antholuo/rnm-75E/3d outputs/4b918af5-770b-4cc3-8189-42923c4cc60b.PNG

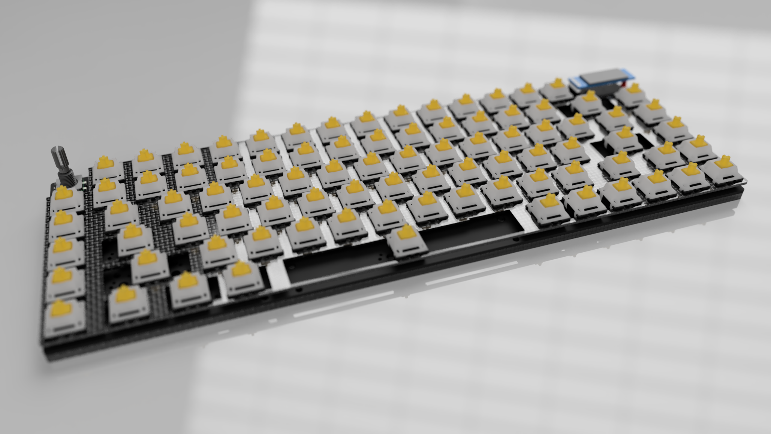
3d outputs/4b918af5-770b-4cc3-8189-42923c4cc60b.PNG
