antholuo/rnm-75E/PLOTS/keyboard-layout (1).png

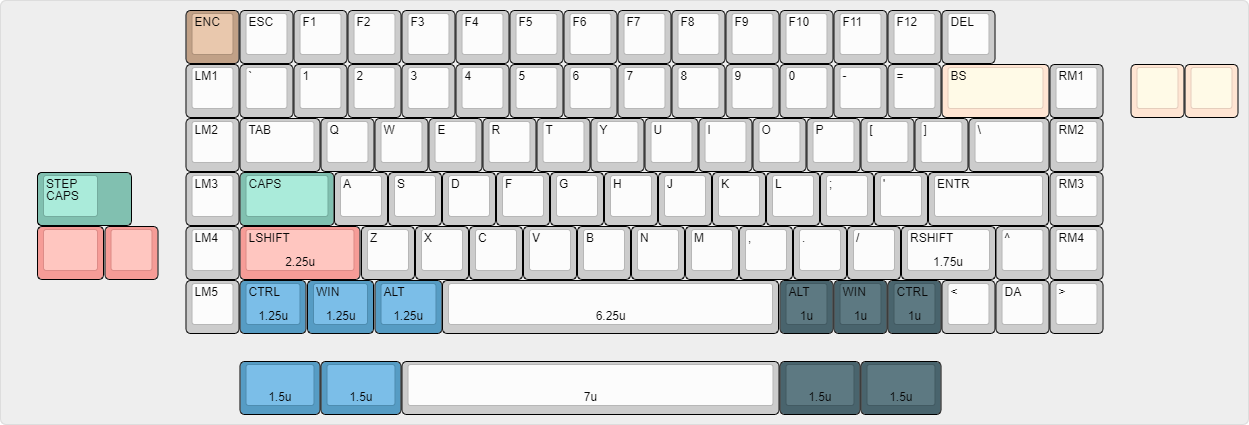
PLOTS/keyboard-layout (1).png
