antholuo/rnm-75E/3d outputs/plate_hopefully.dxf

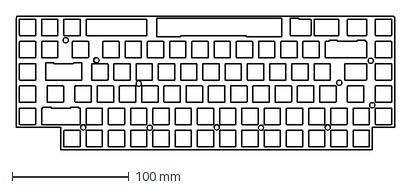
[picture p3: CAD file, 2021-05-18]
3d outputs/plate_hopefully.dxf
323.8 x 114.3 mm
