antholuo/rnm-75E/3d outputs/asm_mx_asm_PCB.stp

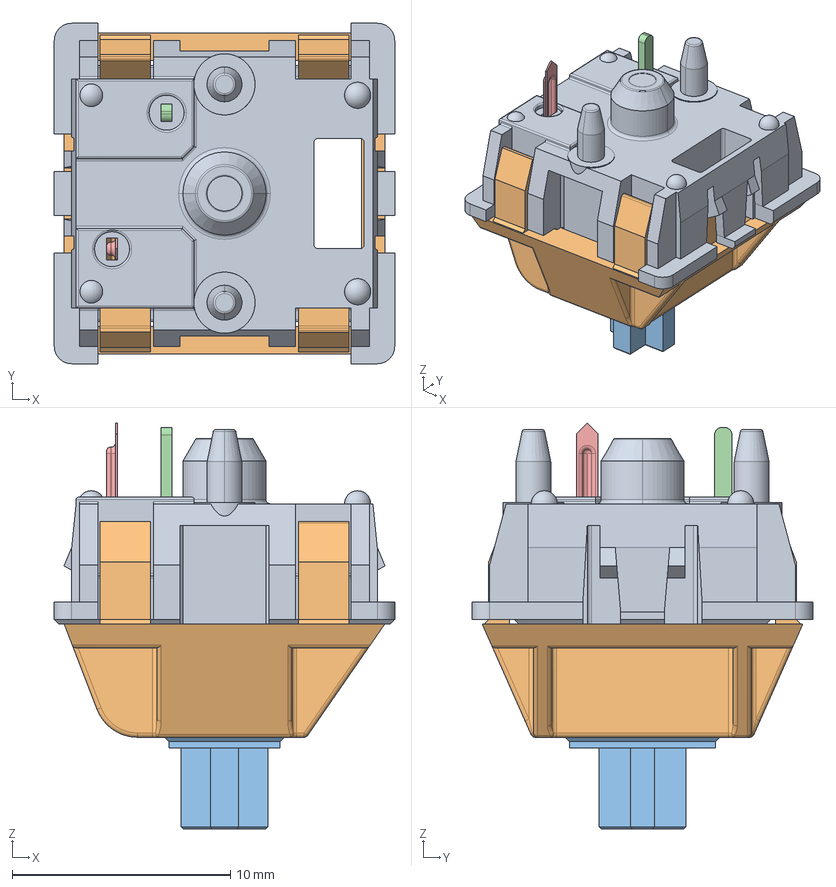
[picture p4: CAD file, 2021-05-16]
3d outputs/asm_mx_asm_PCB.stp
15.6 x 15.6 x 18.6 mm
MX_DOWN
MX_UP
UP_MX
MX_PIN
MX_SPRING
MX_CLICK
