antholuo/rnm-75E/PLATE/midplate2.dxf

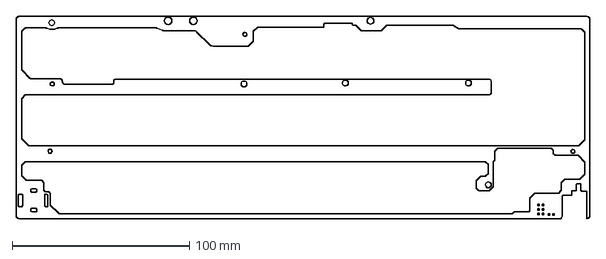
[picture p5: CAD file, 2021-05-29]
PLATE/midplate2.dxf
323.9 x 114.3 mm
