antholuo/rnm-75E/3d outputs/kbplate_with_holes v12.dxf

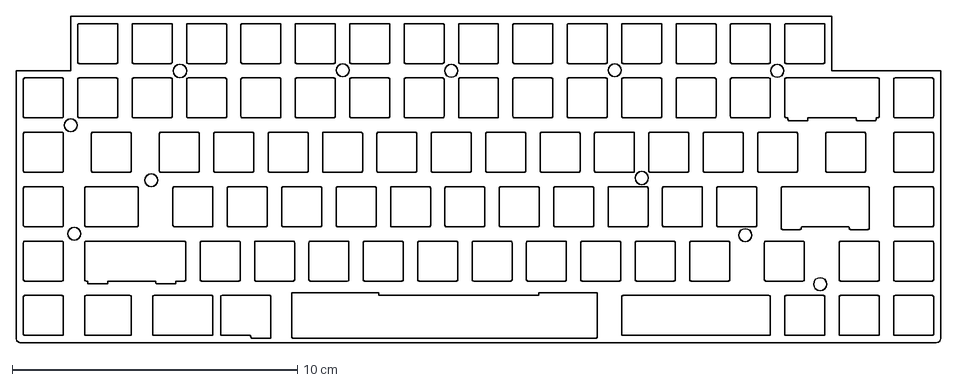
[picture p6: CAD file, 2021-05-18]
3d outputs/kbplate_with_holes v12.dxf
32.4 x 11.4 cm
