antholuo/rnm-75E/3d outputs/platev12wepray2.dxf

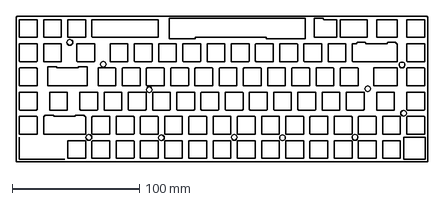
[picture p7: CAD file, 2021-05-18]
3d outputs/platev12wepray2.dxf
323.9 x 114.3 mm
