antholuo/rnm-75E/PLATE/midplate4.dxf

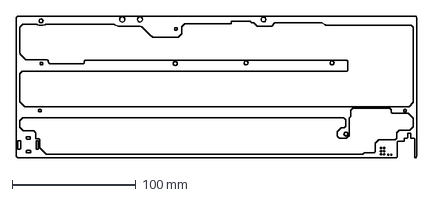
[picture p8: CAD file, 2021-05-29]
PLATE/midplate4.dxf
323.8 x 114.3 mm
