antholuo/rnm-75E/3d outputs/platev12wepray.dxf

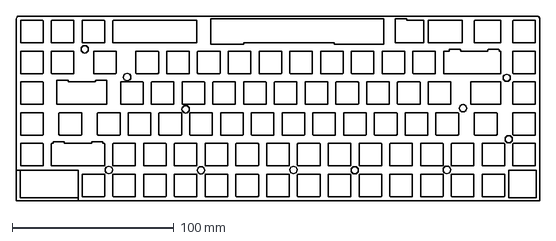
[picture p9: CAD file, 2021-05-18]
3d outputs/platev12wepray.dxf
323.9 x 114.3 mm
