antholuo/rnm-75E/PLATE/plate.step

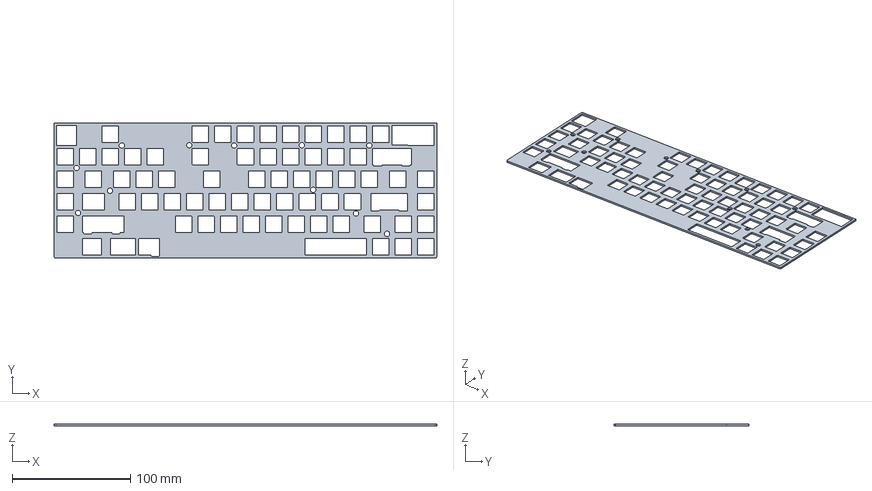
[picture p10: CAD file, 2021-05-22]
PLATE/plate.step
323.8 x 114.3 x 1.60 mm
