antholuo/rnm-75E/3d outputs/kbplate_with_holes v11.step

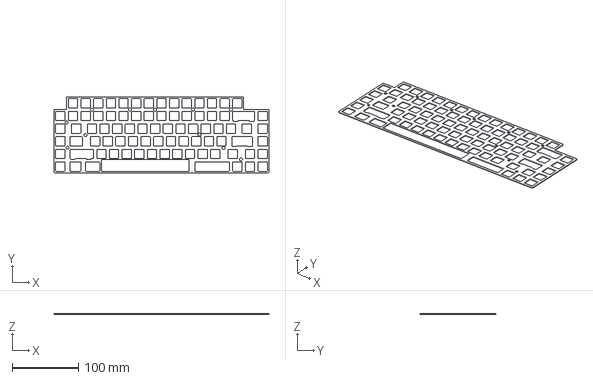
[picture p11: CAD file, 2021-05-18]
3d outputs/kbplate_with_holes v11.step
323.9 x 114.3 x 1.50 mm
