antholuo/rnm-75E/PLATE/midlayer v9.dxf

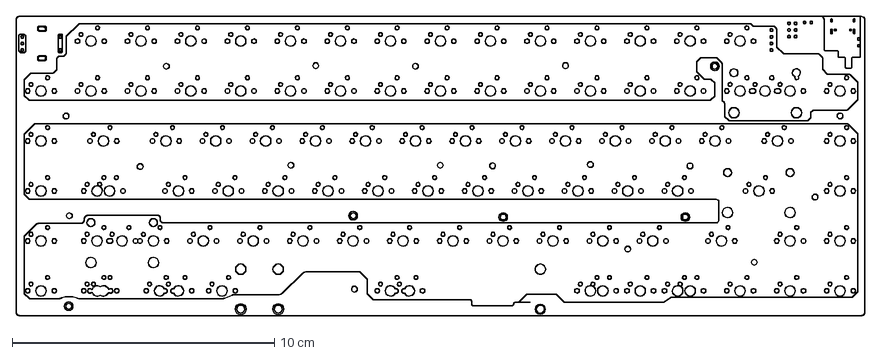
[picture p12: CAD file, 2021-05-22]
PLATE/midlayer v9.dxf
32.4 x 11.4 cm
