antholuo/rnm-75E/PLATE/midplate1.dxf

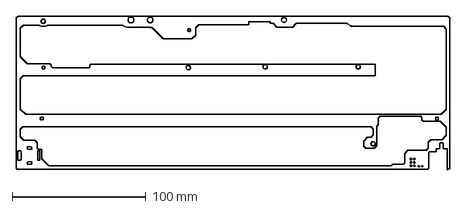
[picture p13: CAD file, 2021-05-22]
PLATE/midplate1.dxf
323.9 x 114.3 mm
