antholuo/rnm-75E/PLATE/midlayer v15.step

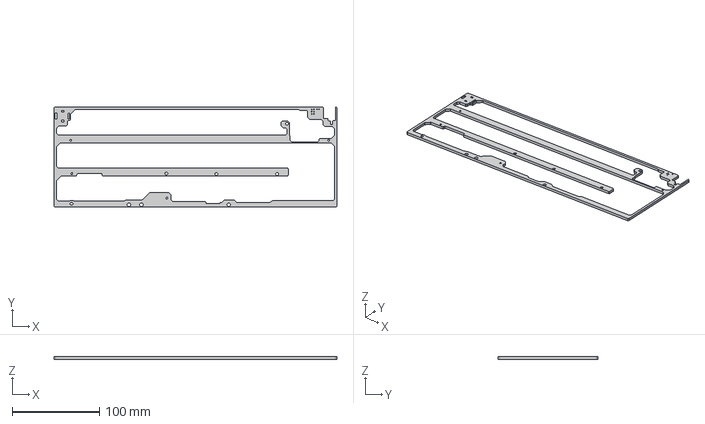
[picture p14: CAD file, 2021-05-22]
PLATE/midlayer v15.step
323.8 x 114.3 x 3.00 mm
