antholuo/rnm-75E/3d outputs/EC11_Rotary_Encoder_Switched.step

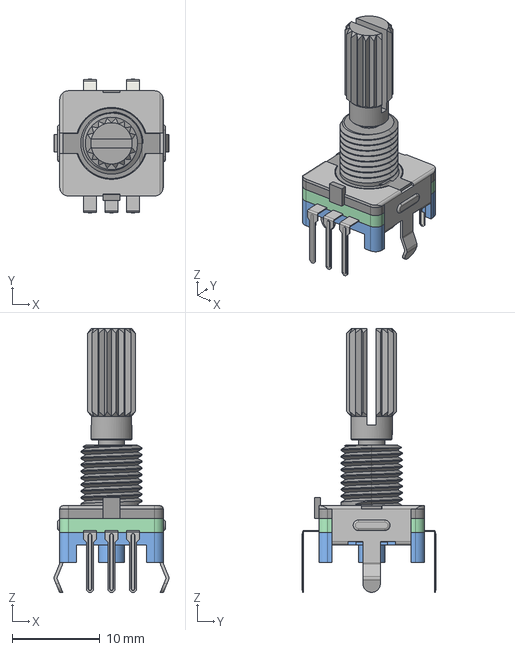
[picture p15: CAD file, 2021-05-17]
3d outputs/EC11_Rotary_Encoder_Switched.step
13.1 x 15.3 x 30.1 mm
