antholuo/rnm-75E/3d outputs/kbplate.dxf

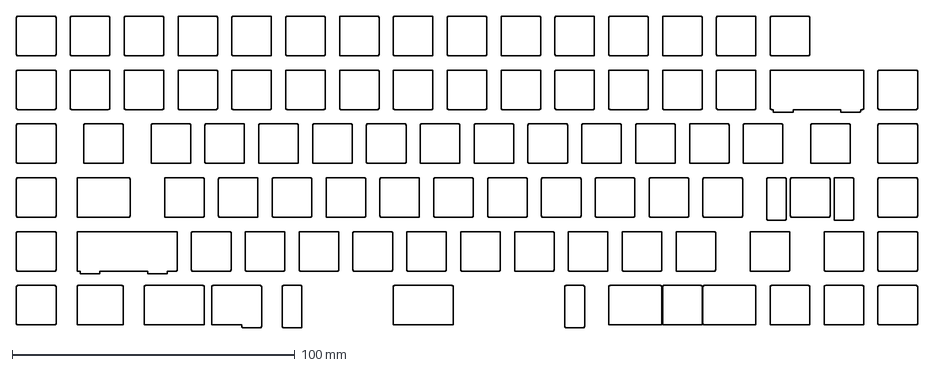
[picture p16: CAD file, 2021-05-16]
3d outputs/kbplate.dxf
318.8 x 110.2 mm
