antholuo/rnm-75E/3d outputs/ai03 plate.dxf

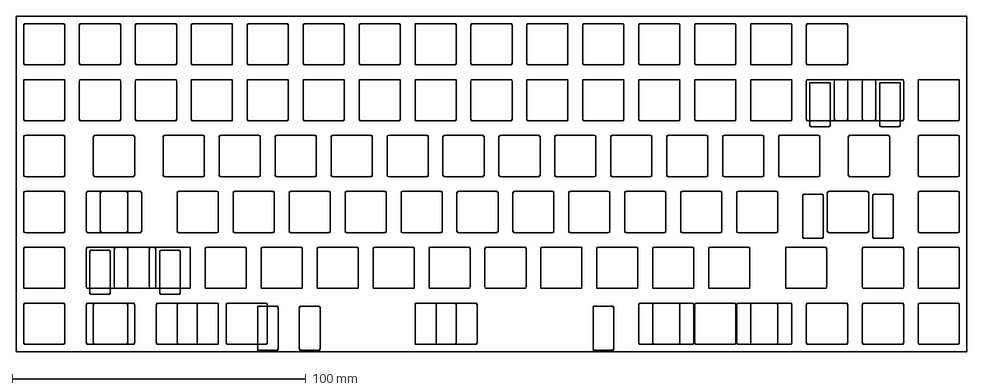
[picture p17: CAD file, 2021-05-16]
3d outputs/ai03 plate.dxf
323.9 x 114.3 mm
