antholuo/rnm-75E/3d outputs/OLED 32x 128.SLDPRT

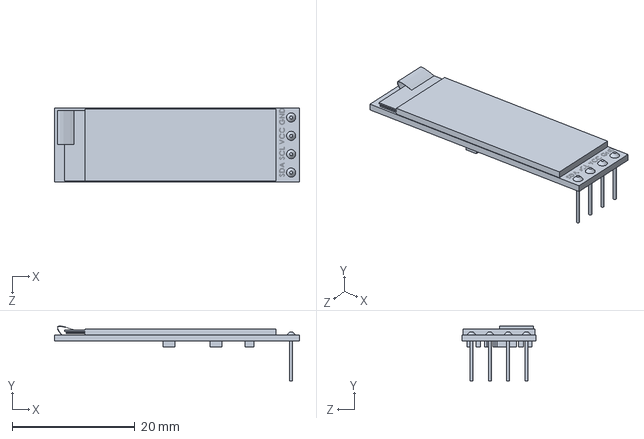
[picture p18: CAD file, 2021-05-16]
3d outputs/OLED 32x 128.SLDPRT
40.0 x 8.96 x 12.0 mm
