antholuo/rnm-75E/3d outputs/Monochrome 0.91’’ 128x32 I2C OLED Display DFR0647 (DFROBOT).STEP

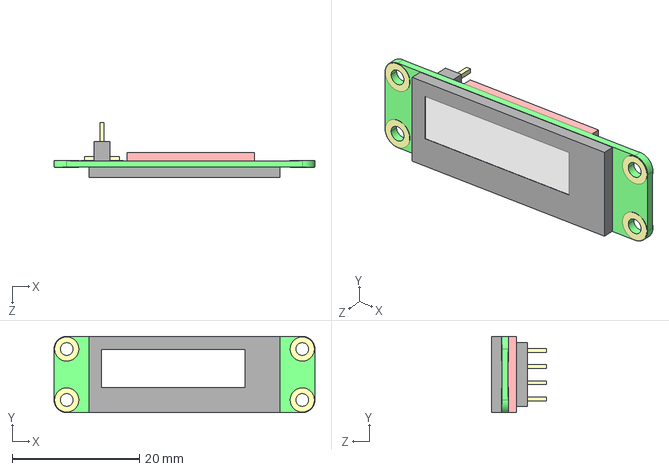
[picture p19: CAD file, 2021-05-16]
3d outputs/Monochrome 0.91’’ 128x32 I2C OLED Display DFR0647 (DFROBOT).STEP
41.0 x 12.0 x 8.60 mm
