antholuo/rnm-75E/3d outputs/plate-20210514-165338.dxf

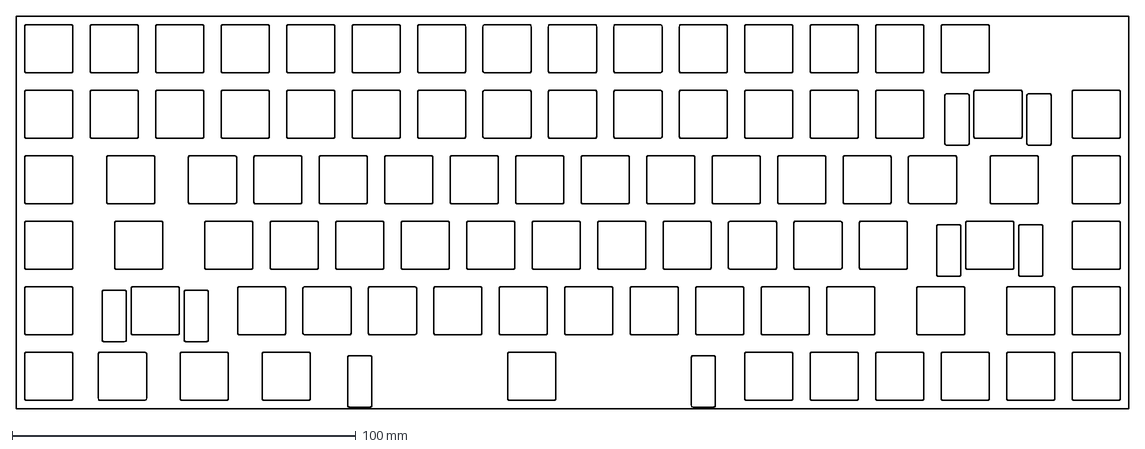
[picture p20: CAD file, 2021-05-15]
3d outputs/plate-20210514-165338.dxf
323.9 x 114.3 mm
