antholuo/rnm-75E/3d outputs/plate_no_oled.dxf

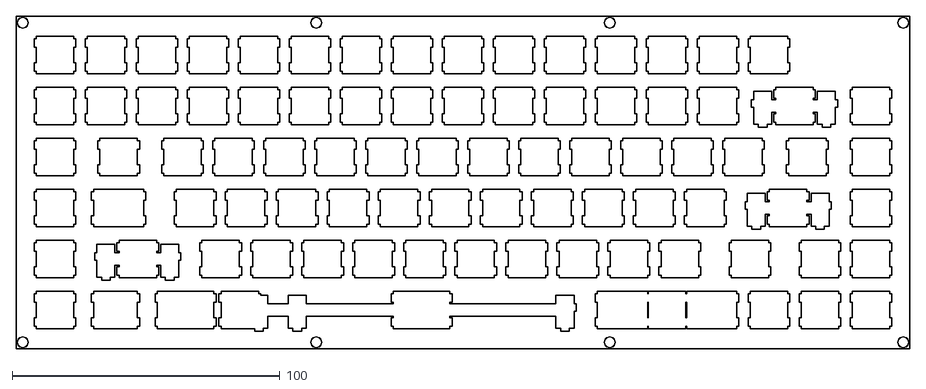
[picture p21: CAD file, 2021-05-15]
3d outputs/plate_no_oled.dxf
333.8 x 124.3
