antholuo/rnm-75E/3d outputs/SSD1306_OLED-0.91-128x32.step

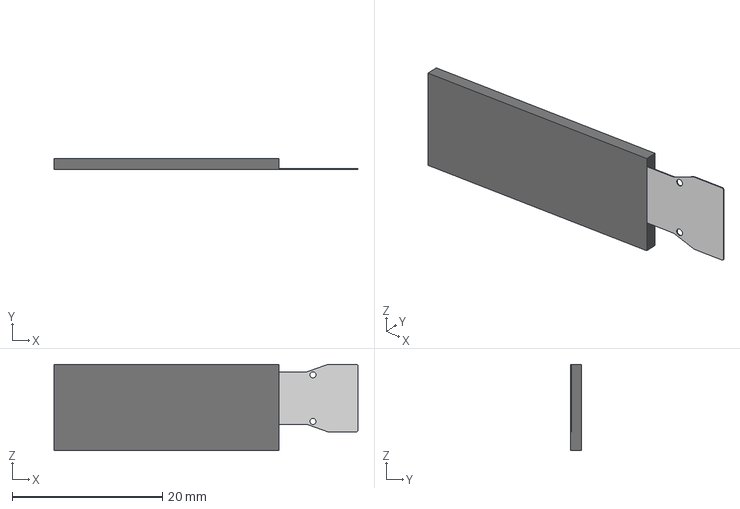
[picture p22: CAD file, 2021-05-12]
3d outputs/SSD1306_OLED-0.91-128x32.step
40.5 x 1.45 x 11.5 mm
