antholuo/rnm-75E/(list of files, cad)

Other CAD files:
3d outputs/kbplate_with_holes v17.dwg
3d outputs/plate1.stl
3d outputs/kbplate_with_holes v11.dxf
