antholuo/rnm-75E/PLOTS/rnm-75E.pdf

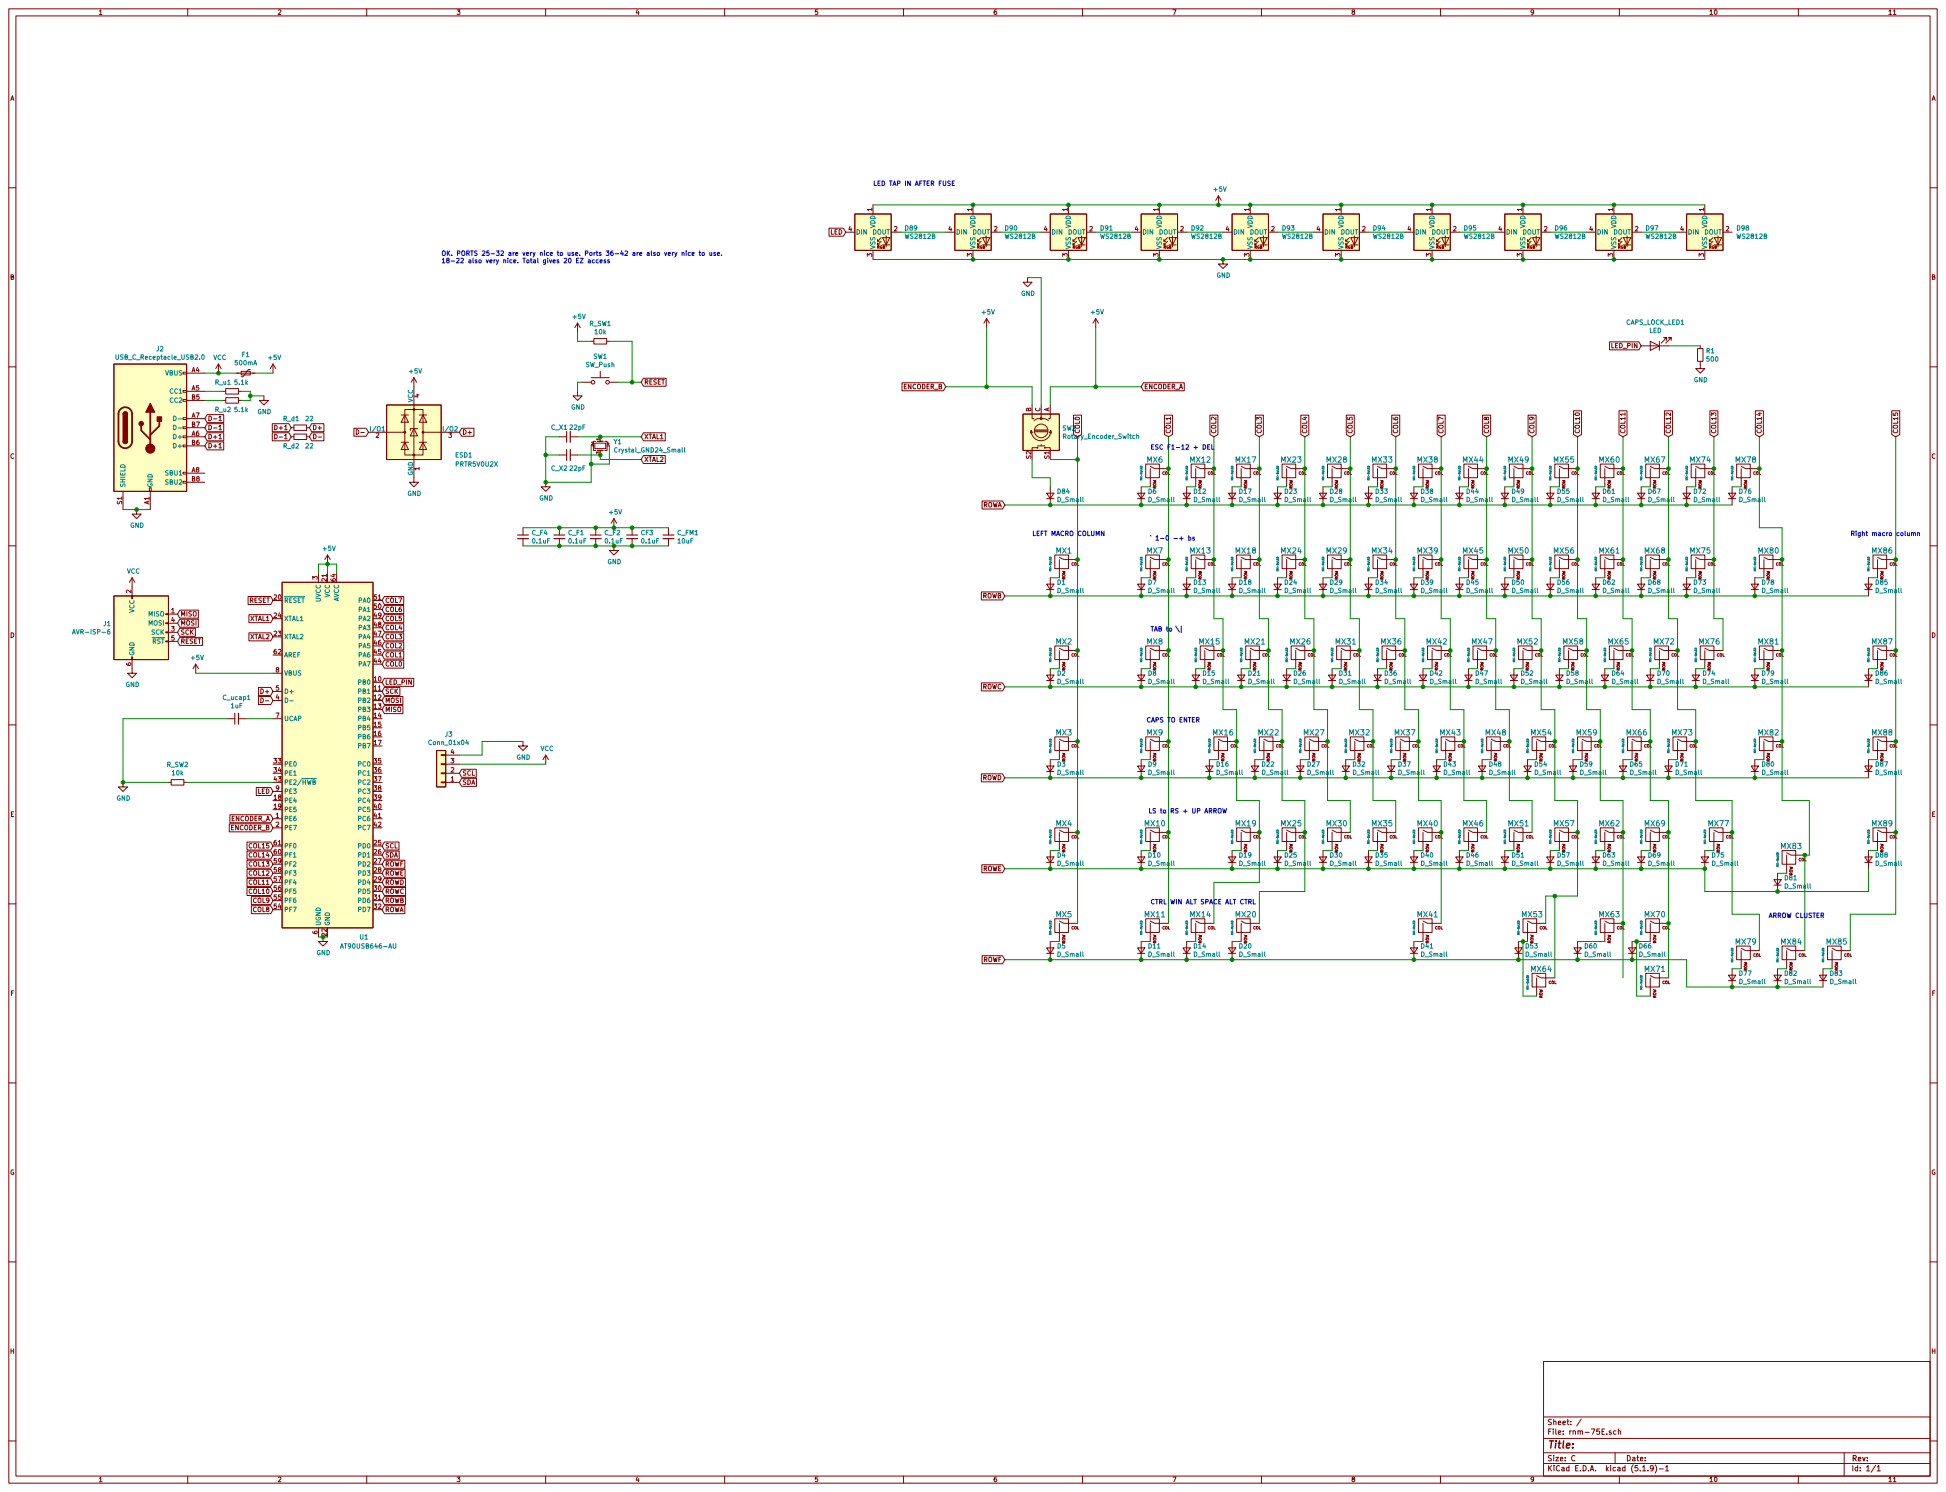
[picture p23: page 1]

LED TAP IN AFTER FUSE

TAB to \| ` 1-0 -+ bs ESC F1-12 + DEL OK. PORTS 25-32 are very nice to use. Ports 36-42 are also very nice to use.
18-22 also very nice. Total gives 20 EZ access
SW1 SW_Push GND

A S2S1 SW2 Rotary_Encoder_Switch D85 D_Small COL ROW MX86 MX-NoLED D75 D_Small COL ROW MX77 MX-NoLED D69 D_Small COL ROW MX69 MX-NoLED D63 D_Small

COL ROW MX74 MX-NoLED

D76 D_Small COL ROW MX78 MX-NoLED

COL ROW MX24 MX-NoLED D18 D_Small COL ROW MX18 MX-NoLED D13 D_Small COL ROW MX13 MX-NoLED D7D_Small COL ROW MX7 MX-NoLED

6 PF1 60 PF0 61 AREF 62 AVCC 64 UCAP 7 VBUS 8 PE3 9 U1 AT90USB646-AU D60 D_Small COL ROW MX63 MX-NoLED COL ROW MX70 MX-NoLED D41 D_Small D3D_Small D20 D_Small COL ROW MX20 MX-NoLED D14 D_Small COL ROW MX14 MX-NoLED D11 D_Small COL ROW MX11 MX-NoLED

2 SCK 3 MOSI 4 RST 5 GND

COL ROW MX65 MX-NoLED

COL ROW MX87 MX-NoLED

COL ROW MX16 MX-NoLED D9D_Small COL ROW MX9 MX-NoLED

LS to RS + UP ARROW
COL ROW MX30 MX-NoLED D25 D_Small COL ROW MX25 MX-NoLED D19 D_Small COL ROW MX19 MX-NoLED D10 D_Small COL ROW MX10 MX-NoLED

SCL ROWA ROWF ROWD

COL ROW MX41 MX-NoLED

COL ROW MX53 MX-NoLED

COL ROW MX79 MX-NoLED

D83 D_Small COL ROW MX85 MX-NoLED D77 D_Small

COL ROW MX64 MX-NoLED

Id: 1/1 Title: File: rnm-75E.sch Sheet: /
