antholuo/rnm-75E/PLOTS/rnm-75e-oneone.pdf

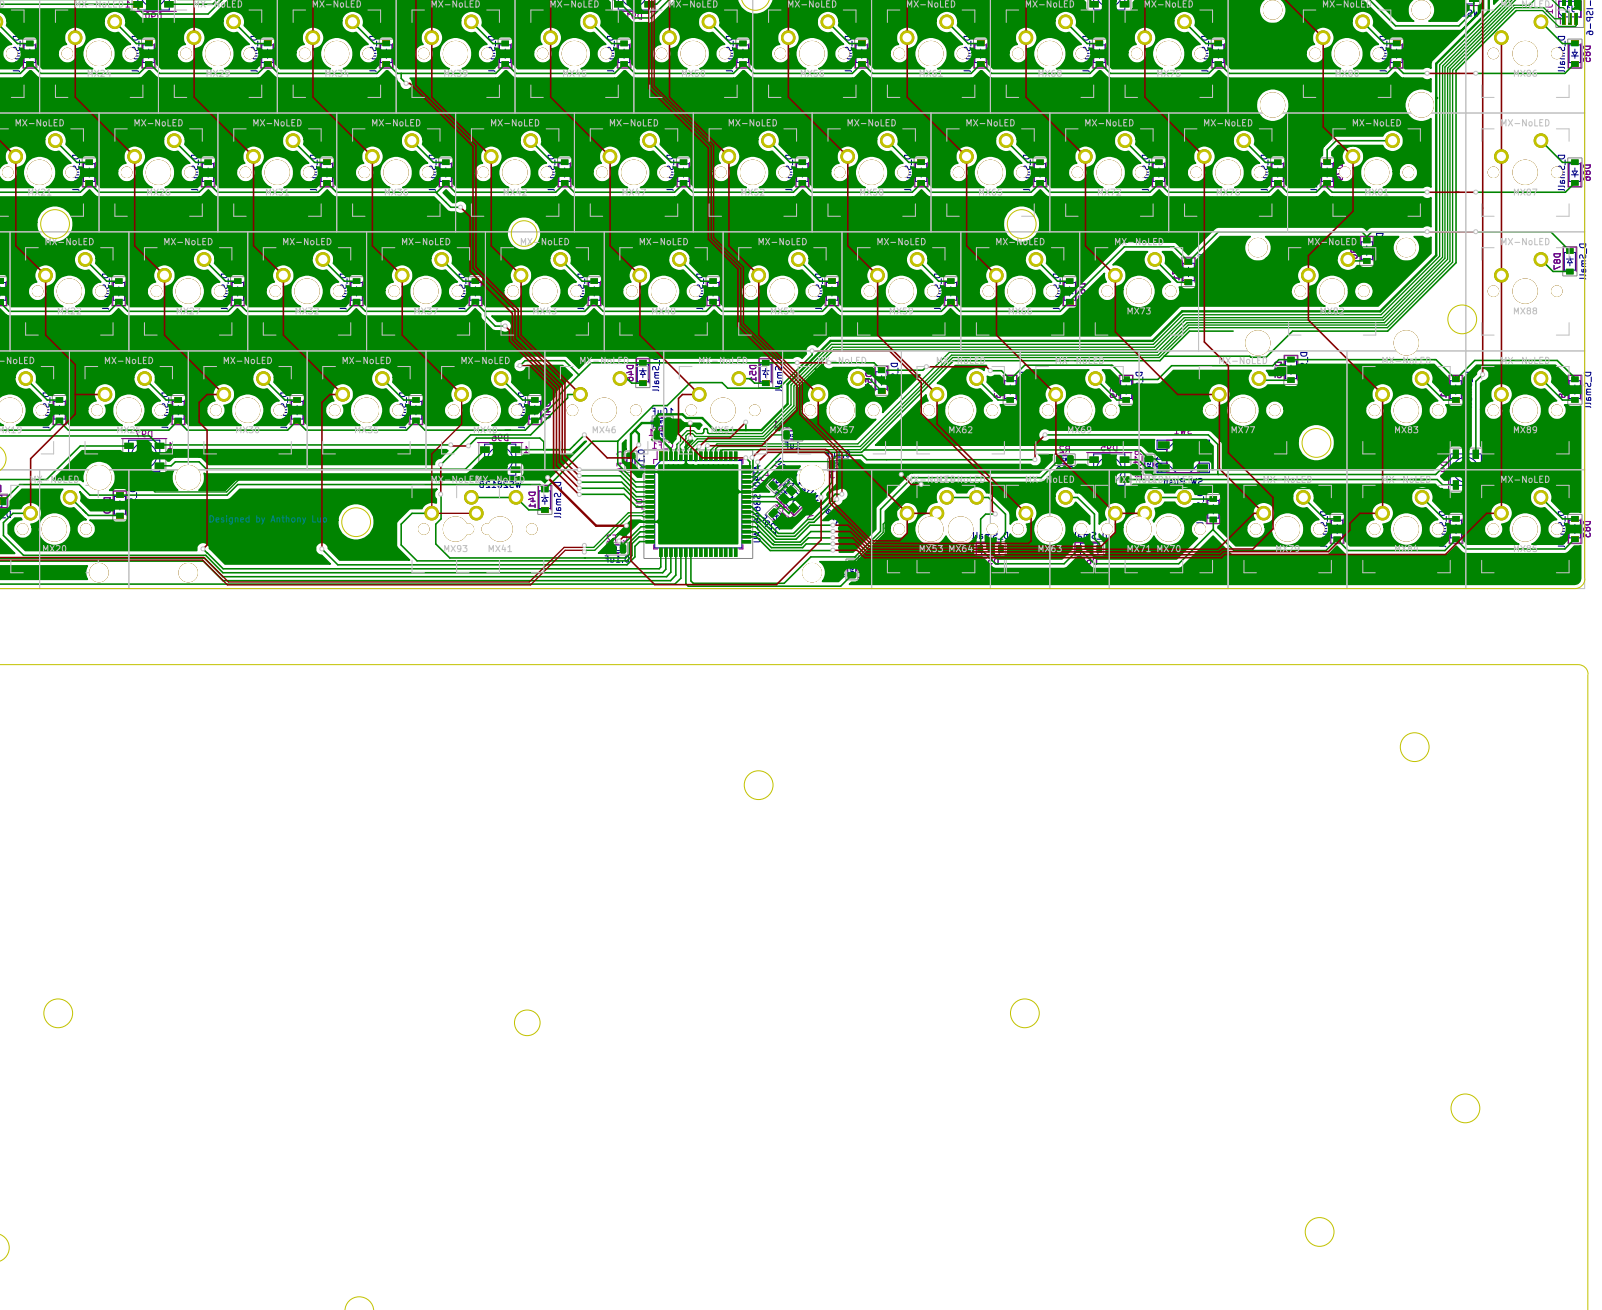
[picture p24: page 1]
