antholuo/rnm-75E/PLOTS/render.pdf

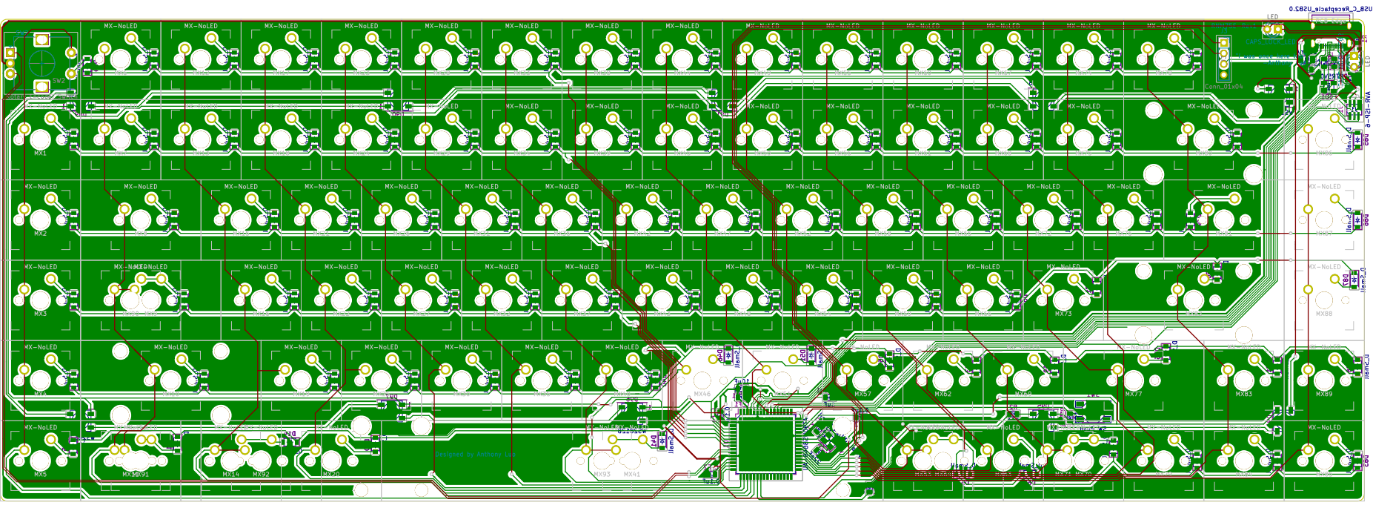
[picture p25: page 1]
