antholuo/rnm-75E/(list of files, drawings)

Other design files:
3d outputs/rnm-75E.dsn
