antholuo/rnm-75E/rnm-75E.kicad_pcb

## KiCad design rnm-75E.kicad_pcb (2021-05-18)

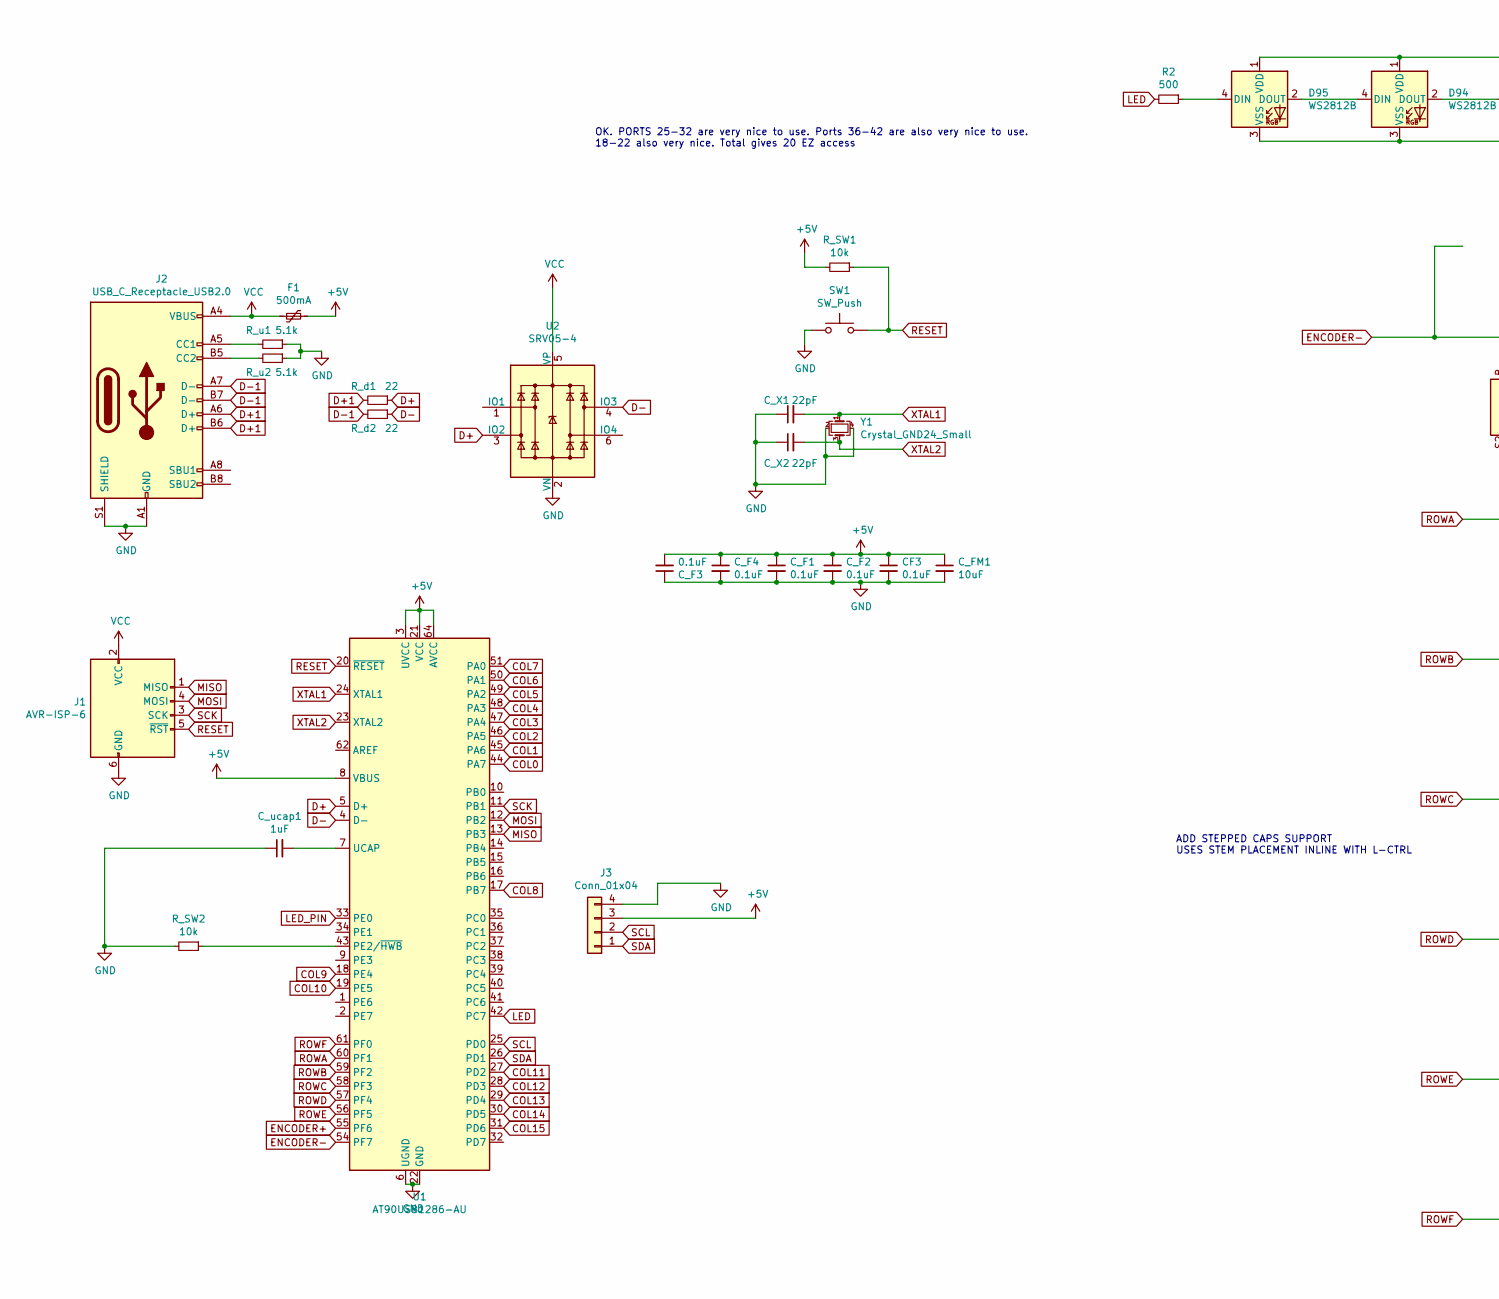
[picture p26: schematic rnm-75E.sch, part in row 1, column 1]

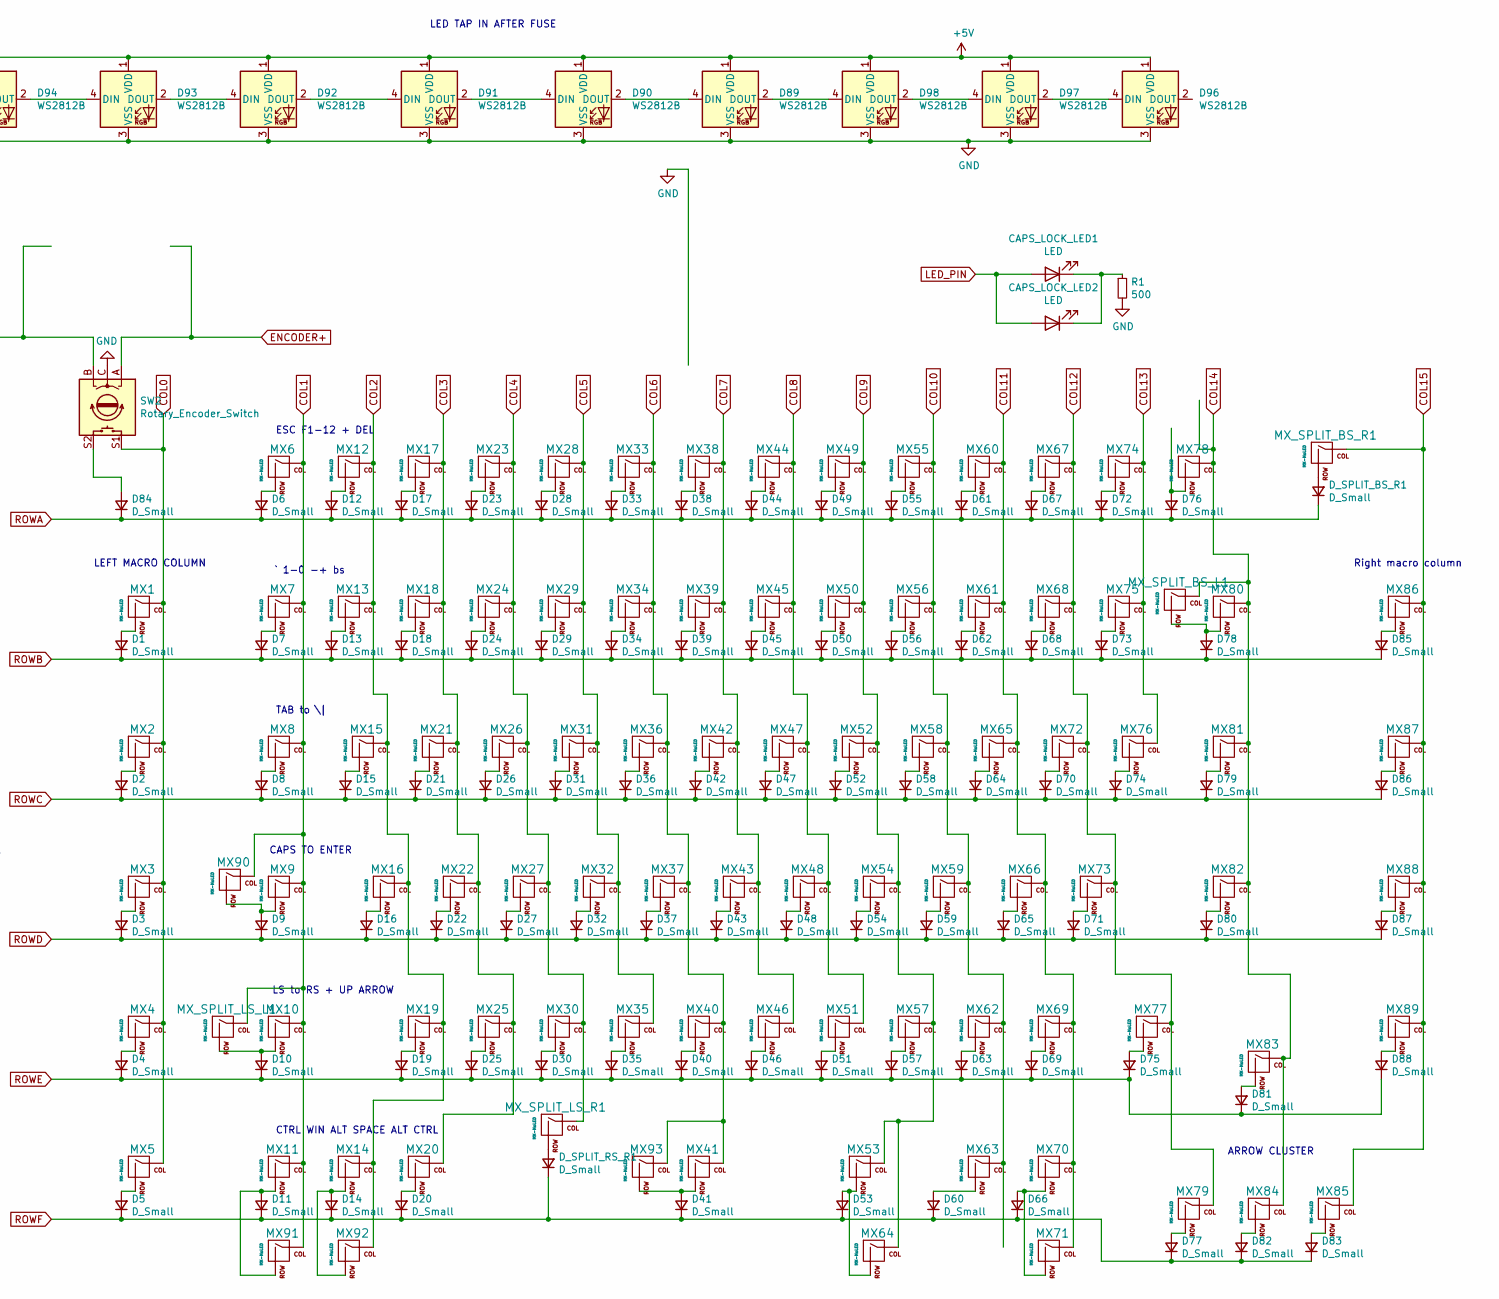
[picture p27: schematic rnm-75E.sch, part in row 1, column 2]

Parts:
CAPS_LOCK_LED1, CAPS_LOCK_LED2: LED; LED_D3.0mm
CF3: 0.1uF; C_0805_2012Metric
C_F1, C_F2, C_F3, C_F4: 0.1uF; C_0805_2012Metric
C_FM1: 10uF; C_0805_2012Metric
C_X1, C_X2: 22pF; C_0805_2012Metric
C_ucap1: 1uF; C_0805_2012Metric
D1, D2, D3, D4, D5, D6, D7, D8, D9, D10, D11, D12, D13, D14, D15, D16, D17, D18, D19, D20, D21, D22, D23, D24, D25, D26, D27, D28, D29, D30, D31, D32, D33, D34, D35, D36, D37, D38, D39, D40, D41, D42, D43, D44, D45, D46, D47, D48, D49, D50, D51, D52, D53, D54, D55, D56, D57, D58, D59, D60, D61, D62, D63, D64, D65, D66, D67, D68, D69, D70, D71, D72, D73, D74, D75, D76, D77, D78, D79, D80, D81, D82, D83, D84, D85, D86, D87, D88: D_Small; D_SOD-123
D89, D90, D91, D92, D93, D94, D95, D96, D97, D98: WS2812B; LED_WS2812B_PLCC4_5.0x5.0mm_P3.2mm
D_SPLIT_BS_R1: D_Small; D_SOD-123
D_SPLIT_RS_R1: D_Small; D_SOD-123
F1: 500mA; Fuse_1206_3216Metric
J1: AVR-ISP-6; Reset_Pretty-Mask
J2: USB_C_Receptacle_USB2.0; USB_C_Receptacle_HRO_TYPE-C-31-M-12
J3: Conn_01x04; PinSocket_1x04_P2.54mm_Vertical
MX1, MX2, MX3, MX4, MX5, MX6, MX7, MX12, MX13, MX15, MX16, MX17, MX18, MX19, MX21, MX22, MX23, MX24, MX25, MX26, MX27, MX28, MX29, MX30, MX31, MX32, MX33, MX34, MX35, MX36, MX37, MX38, MX39, MX40, MX42, MX43, MX44, MX45, MX46, MX47, MX48, MX49, MX50, MX51, MX52, MX53, MX54, MX55, MX56, MX57, MX58, MX59, MX60, MX61, MX62, MX63, MX65, MX66, MX67, MX68, MX69, MX70, MX72, MX73, MX74, MX75, MX76, MX78, MX79, MX83, MX84, MX85, MX86, MX87, MX88, MX89: MX-NoLED; MXOnly-1U-NoLED
MX8, MX64, MX71, MX81, MX91, MX92: MX-NoLED; MXOnly-1.5U-NoLED
MX9, MX77: MX-NoLED; MXOnly-1.75U-NoLED
MX10, MX82: MX-NoLED; MXOnly-2.25U-NoLED
MX11, MX14, MX20, MX90: MX-NoLED; MXOnly-1.25U-NoLED
MX41: MX-NoLED; MXOnly-6.25U-ReversedStabilizers-NoLED
MX80: MX-NoLED; MXOnly-2U-NoLED
MX93: MX-NoLED; MXOnly-7U-ReversedStabilizers-NoLED
MX_SPLIT_BS_L1: MX-NoLED; MXOnly-1U-NoLED
MX_SPLIT_BS_R1: MX-NoLED; MXOnly-1U-NoLED
MX_SPLIT_LS_L1: MX-NoLED; MXOnly-1.25U-NoLED
MX_SPLIT_LS_R1: MX-NoLED; MXOnly-1U-NoLED
R1, R2: 500; R_0805_2012Metric
R_SW1, R_SW2: 10k; R_0805_2012Metric
R_d1, R_d2: 22; R_0805_2012Metric
R_u1, R_u2: 5.1k; R_0805_2012Metric
SW1: SW_Push; SKQG-1155865
SW2: Rotary_Encoder_Switch; RotaryEncoder_Alps_EC11E-Switch_Vertical_H20mm
U1: AT90USB1286-AU; TQFP-64_14x14mm_P0.8mm
U2: SRV05-4; SOT-23-6
Y1: Crystal_GND24_Small; Crystal_SMD_3225-4Pin_3.2x2.5mm

Connections:
+5V: CF3.1, C_F1.1, C_F2.1, C_F3.2, C_F4.1, C_FM1.1, D89.1 (VDD), D90.1 (VDD), D91.1 (VDD), D92.1 (VDD), D93.1 (VDD), D94.1 (VDD), D95.1 (VDD), D96.1 (VDD), D97.1 (VDD), D98.1 (VDD), F1.1, J3.3, R_SW1.2, U1.3 (UVCC), U1.8 (VBUS), U1.21 (VCC), U1.52 (VCC), U1.64 (AVCC)
COL0: MX1.1 (COL), MX2.1 (COL), MX3.1 (COL), MX4.1 (COL), MX5.1 (COL), SW2.S1, U1.44 (PA7)
COL1: MX6.1 (COL), MX7.1 (COL), MX8.1 (COL), MX9.1 (COL), MX10.1 (COL), MX11.1 (COL), MX90.1 (COL), MX91.1 (COL), MX_SPLIT_LS_L1.1 (COL), U1.45 (PA6)
COL2: MX12.1 (COL), MX13.1 (COL), MX14.1 (COL), MX15.1 (COL), MX16.1 (COL), MX19.1 (COL), MX92.1 (COL), U1.46 (PA5)
COL3: MX17.1 (COL), MX18.1 (COL), MX20.1 (COL), MX21.1 (COL), MX22.1 (COL), MX25.1 (COL), U1.47 (PA4)
COL4: MX23.1 (COL), MX24.1 (COL), MX26.1 (COL), MX27.1 (COL), MX30.1 (COL), MX_SPLIT_LS_R1.1 (COL), U1.48 (PA3)
COL5: MX28.1 (COL), MX29.1 (COL), MX31.1 (COL), MX32.1 (COL), MX35.1 (COL), U1.49 (PA2)
COL6: MX33.1 (COL), MX34.1 (COL), MX36.1 (COL), MX37.1 (COL), MX40.1 (COL), MX41.1 (COL), MX93.1 (COL), U1.50 (PA1)
COL7: MX38.1 (COL), MX39.1 (COL), MX42.1 (COL), MX43.1 (COL), MX46.1 (COL), U1.51 (PA0)
COL8: MX44.1 (COL), MX45.1 (COL), MX47.1 (COL), MX48.1 (COL), MX51.1 (COL), U1.17 (PB7)
COL9: MX49.1 (COL), MX50.1 (COL), MX52.1 (COL), MX53.1 (COL), MX54.1 (COL), MX57.1 (COL), MX64.1 (COL), U1.18 (PE4)
COL10: MX55.1 (COL), MX56.1 (COL), MX58.1 (COL), MX59.1 (COL), MX62.1 (COL), MX63.1 (COL), U1.19 (PE5)
COL11: MX60.1 (COL), MX61.1 (COL), MX65.1 (COL), MX66.1 (COL), MX69.1 (COL), MX70.1 (COL), MX71.1 (COL), U1.27 (PD2)
COL12: MX67.1 (COL), MX68.1 (COL), MX72.1 (COL), MX73.1 (COL), MX77.1 (COL), MX79.1 (COL), U1.28 (PD3)
COL13: MX74.1 (COL), MX75.1 (COL), MX76.1 (COL), U1.29 (PD4)
COL14: MX78.1 (COL), MX80.1 (COL), MX81.1 (COL), MX82.1 (COL), MX83.1 (COL), MX84.1 (COL), MX_SPLIT_BS_L1.1 (COL), U1.30 (PD5)
COL15: MX85.1 (COL), MX86.1 (COL), MX87.1 (COL), MX88.1 (COL), MX89.1 (COL), MX_SPLIT_BS_R1.1 (COL), U1.31 (PD6)
D+: R_d1.1, U1.5 (D+), U2.3 (IO2)
D+1: J2.A6 (D+), J2.B6 (D+), R_d1.2
D-: R_d2.1, U1.4 (D-), U2.4 (IO3)
D-1: J2.A7 (D-), J2.B7 (D-), R_d2.2
ENCODER+: SW2.A, U1.55 (PF6)
ENCODER-: SW2.B, U1.54 (PF7)
GND: CF3.2, C_F1.2, C_F2.2, C_F3.1, C_F4.2, C_FM1.2, C_X1.1, C_X2.1, C_ucap1.1, D89.3 (VSS), D90.3 (VSS), D91.3 (VSS), D92.3 (VSS), D93.3 (VSS), D94.3 (VSS), D95.3 (VSS), D96.3 (VSS), D97.3 (VSS), D98.3 (VSS), J1.6 (GND), J2.A1 (GND), J2.A12 (GND), J2.B1 (GND), J2.B12 (GND), J2.S1 (SHIELD), J3.4, R1.2, R_SW2.2, R_u1.1, R_u2.1, SW1.1, SW2.C, U1.6 (UGND), U1.22 (GND), U1.53 (GND), U1.63 (GND), U2.2 (VN), Y1.2, Y1.4
LED: R2.2, U1.42 (PC7)
LED_PIN: CAPS_LOCK_LED1.2 (A), CAPS_LOCK_LED2.2 (A), U1.33 (PE0)
MISO: J1.1 (MISO), U1.13 (PB3)
MOSI: J1.4 (MOSI), U1.12 (PB2)
unnamed: CAPS_LOCK_LED1.1 (K), CAPS_LOCK_LED2.1 (K), R1.1
unnamed: C_ucap1.2, U1.7 (UCAP)
unnamed: D1.2 (A), MX1.2 (ROW)
unnamed: D2.2 (A), MX2.2 (ROW)
unnamed: D3.2 (A), MX3.2 (ROW)
unnamed: D4.2 (A), MX4.2 (ROW)
unnamed: D5.2 (A), MX5.2 (ROW)
unnamed: D6.2 (A), MX6.2 (ROW)
unnamed: D7.2 (A), MX7.2 (ROW)
unnamed: D8.2 (A), MX8.2 (ROW)
unnamed: D9.2 (A), MX9.2 (ROW), MX90.2 (ROW)
unnamed: D10.2 (A), MX10.2 (ROW), MX_SPLIT_LS_L1.2 (ROW)
unnamed: D11.2 (A), MX11.2 (ROW), MX91.2 (ROW)
unnamed: D12.2 (A), MX12.2 (ROW)
unnamed: D13.2 (A), MX13.2 (ROW)
unnamed: D14.2 (A), MX14.2 (ROW), MX92.2 (ROW)
unnamed: D15.2 (A), MX15.2 (ROW)
unnamed: D16.2 (A), MX16.2 (ROW)
unnamed: D17.2 (A), MX17.2 (ROW)
unnamed: D18.2 (A), MX18.2 (ROW)
unnamed: D19.2 (A), MX19.2 (ROW)
unnamed: D20.2 (A), MX20.2 (ROW)
unnamed: D21.2 (A), MX21.2 (ROW)
unnamed: D22.2 (A), MX22.2 (ROW)
unnamed: D23.2 (A), MX23.2 (ROW)
unnamed: D24.2 (A), MX24.2 (ROW)
unnamed: D25.2 (A), MX25.2 (ROW)
unnamed: D26.2 (A), MX26.2 (ROW)
unnamed: D27.2 (A), MX27.2 (ROW)
unnamed: D28.2 (A), MX28.2 (ROW)
unnamed: D29.2 (A), MX29.2 (ROW)
unnamed: D30.2 (A), MX30.2 (ROW)
unnamed: D31.2 (A), MX31.2 (ROW)
unnamed: D32.2 (A), MX32.2 (ROW)
unnamed: D33.2 (A), MX33.2 (ROW)
unnamed: D34.2 (A), MX34.2 (ROW)
unnamed: D35.2 (A), MX35.2 (ROW)
unnamed: D36.2 (A), MX36.2 (ROW)
unnamed: D37.2 (A), MX37.2 (ROW)
unnamed: D38.2 (A), MX38.2 (ROW)
unnamed: D39.2 (A), MX39.2 (ROW)
unnamed: D40.2 (A), MX40.2 (ROW)
unnamed: D41.2 (A), MX41.2 (ROW), MX93.2 (ROW)
unnamed: D42.2 (A), MX42.2 (ROW)
unnamed: D43.2 (A), MX43.2 (ROW)
unnamed: D44.2 (A), MX44.2 (ROW)
unnamed: D45.2 (A), MX45.2 (ROW)
unnamed: D46.2 (A), MX46.2 (ROW)
unnamed: D47.2 (A), MX47.2 (ROW)
unnamed: D48.2 (A), MX48.2 (ROW)
unnamed: D49.2 (A), MX49.2 (ROW)
unnamed: D50.2 (A), MX50.2 (ROW)
unnamed: D51.2 (A), MX51.2 (ROW)
unnamed: D52.2 (A), MX52.2 (ROW)
unnamed: D53.2 (A), MX53.2 (ROW), MX64.2 (ROW)
unnamed: D54.2 (A), MX54.2 (ROW)
unnamed: D55.2 (A), MX55.2 (ROW)
unnamed: D56.2 (A), MX56.2 (ROW)
unnamed: D57.2 (A), MX57.2 (ROW)
unnamed: D58.2 (A), MX58.2 (ROW)
unnamed: D59.2 (A), MX59.2 (ROW)
unnamed: D60.2 (A), MX63.2 (ROW)
unnamed: D61.2 (A), MX60.2 (ROW)
unnamed: D62.2 (A), MX61.2 (ROW)
unnamed: D63.2 (A), MX62.2 (ROW)
unnamed: D64.2 (A), MX65.2 (ROW)
unnamed: D65.2 (A), MX66.2 (ROW)
unnamed: D66.2 (A), MX70.2 (ROW), MX71.2 (ROW)
unnamed: D67.2 (A), MX67.2 (ROW)
unnamed: D68.2 (A), MX68.2 (ROW)
unnamed: D69.2 (A), MX69.2 (ROW)
unnamed: D70.2 (A), MX72.2 (ROW)
unnamed: D71.2 (A), MX73.2 (ROW)
unnamed: D72.2 (A), MX74.2 (ROW)
unnamed: D73.2 (A), MX75.2 (ROW)
unnamed: D74.2 (A), MX76.2 (ROW)
unnamed: D75.2 (A), MX77.2 (ROW)
unnamed: D76.2 (A), MX78.2 (ROW)
unnamed: D77.2 (A), MX79.2 (ROW)
unnamed: D78.2 (A), MX80.2 (ROW), MX_SPLIT_BS_L1.2 (ROW)
unnamed: D79.2 (A), MX81.2 (ROW)
unnamed: D80.2 (A), MX82.2 (ROW)
unnamed: D81.2 (A), MX83.2 (ROW)
unnamed: D82.2 (A), MX84.2 (ROW)
unnamed: D83.2 (A), MX85.2 (ROW)
unnamed: D84.2 (A), SW2.S2
unnamed: D85.2 (A), MX86.2 (ROW)
unnamed: D86.2 (A), MX87.2 (ROW)
unnamed: D87.2 (A), MX88.2 (ROW)
unnamed: D88.2 (A), MX89.2 (ROW)
unnamed: D89.2 (DOUT), D98.4 (DIN)
unnamed: D89.4 (DIN), D90.2 (DOUT)
unnamed: D90.4 (DIN), D91.2 (DOUT)
unnamed: D91.4 (DIN), D92.2 (DOUT)
unnamed: D92.4 (DIN), D93.2 (DOUT)
unnamed: D93.4 (DIN), D94.2 (DOUT)
unnamed: D94.4 (DIN), D95.2 (DOUT)
unnamed: D95.4 (DIN), R2.1
unnamed: D96.4 (DIN), D97.2 (DOUT)
unnamed: D97.4 (DIN), D98.2 (DOUT)
unnamed: D_SPLIT_BS_R1.2 (A), MX_SPLIT_BS_R1.2 (ROW)
unnamed: D_SPLIT_RS_R1.2 (A), MX_SPLIT_LS_R1.2 (ROW)
unnamed: J2.A5 (CC1), R_u1.2
unnamed: J2.B5 (CC2), R_u2.2
unnamed: R_SW2.1, U1.43 (PE2/~HWB)
RESET: J1.5 (~RST), R_SW1.1, SW1.2, U1.20 (~RESET)
ROWA: D6.1 (K), D12.1 (K), D17.1 (K), D23.1 (K), D28.1 (K), D33.1 (K), D38.1 (K), D44.1 (K), D49.1 (K), D55.1 (K), D61.1 (K), D67.1 (K), D72.1 (K), D76.1 (K), D84.1 (K), D_SPLIT_BS_R1.1 (K), U1.60 (PF1)
ROWB: D1.1 (K), D7.1 (K), D13.1 (K), D18.1 (K), D24.1 (K), D29.1 (K), D34.1 (K), D39.1 (K), D45.1 (K), D50.1 (K), D56.1 (K), D62.1 (K), D68.1 (K), D73.1 (K), D78.1 (K), D85.1 (K), U1.59 (PF2)
ROWC: D2.1 (K), D8.1 (K), D15.1 (K), D21.1 (K), D26.1 (K), D31.1 (K), D36.1 (K), D42.1 (K), D47.1 (K), D52.1 (K), D58.1 (K), D64.1 (K), D70.1 (K), D74.1 (K), D79.1 (K), D86.1 (K), U1.58 (PF3)
ROWD: D3.1 (K), D9.1 (K), D16.1 (K), D22.1 (K), D27.1 (K), D32.1 (K), D37.1 (K), D43.1 (K), D48.1 (K), D54.1 (K), D59.1 (K), D65.1 (K), D71.1 (K), D80.1 (K), D87.1 (K), U1.57 (PF4)
ROWE: D4.1 (K), D10.1 (K), D19.1 (K), D25.1 (K), D30.1 (K), D35.1 (K), D40.1 (K), D46.1 (K), D51.1 (K), D57.1 (K), D63.1 (K), D69.1 (K), D75.1 (K), D81.1 (K), D88.1 (K), U1.56 (PF5)
ROWF: D5.1 (K), D11.1 (K), D14.1 (K), D20.1 (K), D41.1 (K), D53.1 (K), D60.1 (K), D66.1 (K), D77.1 (K), D82.1 (K), D83.1 (K), D_SPLIT_RS_R1.1 (K), U1.61 (PF0)
SCK: J1.3 (SCK), U1.11 (PB1)
SCL: J3.2, U1.25 (PD0)
SDA: J3.1, U1.26 (PD1)
VCC: F1.2, J1.2 (VCC), J2.A4 (VBUS), J2.A9 (VBUS), J2.B4 (VBUS), J2.B9 (VBUS), U2.5 (VP)
XTAL1: C_X1.2, U1.24 (XTAL1), Y1.1
XTAL2: C_X2.2, U1.23 (XTAL2), Y1.3

Notes on the sheet:
OK. PORTS 25-32 are very nice to use. Ports 36-42 are also very nice to use. 18-22 also very nice. Total gives 20 EZ access
ESC F1-12 + DEL
` 1-0 -+ bs
TAB to \|
CAPS TO ENTER
LS to RS + UP ARROW
Right macro column
ARROW CLUSTER
CTRL WIN ALT SPACE ALT CTRL
LEFT MACRO COLUMN
LED TAP IN AFTER FUSE
ADD STEPPED CAPS SUPPORT USES STEM PLACEMENT INLINE WITH L-CTRL

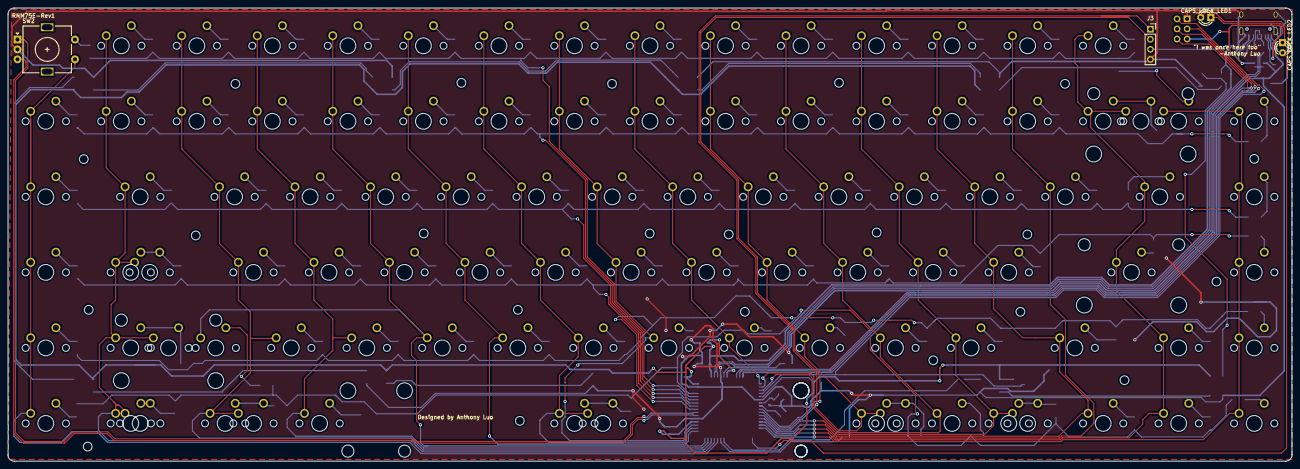
[picture p28: board rnm-75E.kicad_pcb from above]

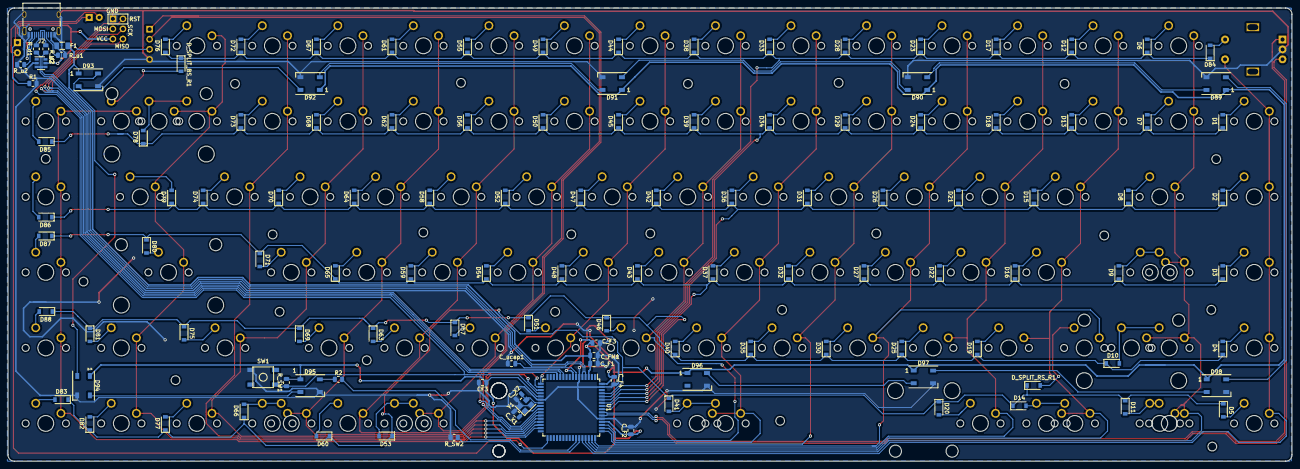
[picture p29: board rnm-75E.kicad_pcb from below]

Board: 2 copper layers, 323.9 x 114.3 mm, 225 parts (124 on the bottom side), 146 nets.
