antholuo/rnm-75E/(commit log)

2021-05-10 init proj
    [rnm-75E.kicad_pcb, rnm-75E.sch]
2021-05-10 mcu side
    [rnm-75E.sch]
2021-05-11 new crystal
    [rnm-75E.sch]
2021-05-11 mcu complete?
    [rnm-75E.sch]
2021-05-11 ref made
    [rnm-75E.sch]
2021-05-12 added ground fill
    [rnm-75E.kicad_pcb, rnm-75E.sch]
2021-05-12 keyboard schematic done
    [rnm-75E.sch]
2021-05-12 wrong encoder
    [rnm-75E.sch]
2021-05-12 place encoder
    [rnm-75E.sch]
2021-05-12 update mcu
    [rnm-75E.sch]
2021-05-12 pcb arranged
    diodes added
    [rnm-75E.kicad_pcb, rnm-75E.sch]
2021-05-13 Added TODO
    [rnm-75E.kicad_pcb]
2021-05-13 stepped caps_lock
    [rnm-75E.kicad_pcb, rnm-75E.sch]
2021-05-13 added 7u space support
    [rnm-75E.kicad_pcb, rnm-75E.sch]
2021-05-13 double caps lock led
    [rnm-75E.kicad_pcb]
2021-05-13 wiring for row 1->4
    [rnm-75E.kicad_pcb, rnm-75E.sch]
2021-05-13 route scl/sda
    [rnm-75E.kicad_pcb, rnm-75E.sch]
2021-05-13 WIRED SPI
    [rnm-75E.kicad_pcb, rnm-75E.sch]
2021-05-13 move sw res
    [rnm-75E.kicad_pcb]
2021-05-13 route column 1-6
    [rnm-75E.kicad_pcb]
2021-05-13 route c7/8
    [rnm-75E.kicad_pcb, rnm-75E.sch]
2021-05-13 row 7 connected
    [rnm-75E.kicad_pcb, rnm-75E.sch]
2021-05-13 route row A-E onto mcu
    [rnm-75E.kicad_pcb, rnm-75E.sch]
2021-05-13 routed encoder
    [rnm-75E.kicad_pcb, rnm-75E.sch]
2021-05-13 Route rows 11/-15
    [rnm-75E.kicad_pcb, rnm-75E.sch]
2021-05-13 visual changes
    [rnm-75E.kicad_pcb]
2021-05-13 neater route 13
    [rnm-75E.kicad_pcb]
2021-05-13 oled and top gnd
    [rnm-75E.kicad_pcb, rnm-75E.sch]
2021-05-13 emcoder routing
    [rnm-75E.kicad_pcb, rnm-75E.sch]
2021-05-13 update LED net
    [rnm-75E.sch]
2021-05-13 add ISP
    [rnm-75E.kicad_pcb]
2021-05-13 all mcu connected
    [rnm-75E.kicad_pcb]
2021-05-13 update ground fill
    [rnm-75E.kicad_pcb]
2021-05-13 update fill zones
    [rnm-75E.kicad_pcb]
2021-05-13 routed to clear crystal
    [rnm-75E.kicad_pcb]
2021-05-13 update led resistor
    [rnm-75E.sch]
2021-05-13 usb vcc routing
    [rnm-75E.kicad_pcb]
2021-05-13 bom + new gerber
    [rnm-75E-B_Cu.gbr, rnm-75E-B_Mask.gbr, rnm-75E-B_Paste.gbr, rnm-75E-B_SilkS.gbr, rnm-75E-Edge_Cuts.gbr, rnm-75E-F_Cu.gbr, rnm-75E-F_Mask.gbr, rnm-75E-F_Paste.gbr]
2021-05-13 mounting locations
    [rnm-75E.kicad_pcb]
2021-05-13 routing changes
    [rnm-75E.kicad_pcb]
2021-05-13 More stable design
    [rnm-75E.kicad_pcb, rnm-75E.sch]
2021-05-13 added new mcu
    [rnm-75E.sch]
2021-05-13 replacement added
    [rnm-75E.kicad_pcb]
2021-05-13 wiring touch ups
    [rnm-75E.kicad_pcb]
2021-05-13 srv05 added
    [rnm-75E.kicad_pcb, rnm-75E.sch]
2021-05-13 update fill
    [rnm-75E.kicad_pcb]
2021-05-14 updated crystal position
    [rnm-75E.kicad_pcb]
2021-05-14 ground fill
    [rnm-75E.kicad_pcb]
2021-05-14 no mounting holes
    [rnm-75E.kicad_pcb]
2021-05-14 updated D+/D-
    [rnm-75E.kicad_pcb]
2021-05-14 rerun main ground
    [rnm-75E.kicad_pcb, rnm-75E.sch]
2021-05-14 updated esd gnd
    [rnm-75E.kicad_pcb]
2021-05-14 update b.cu fill
    [rnm-75E.kicad_pcb]
2021-05-14 swap to hro usbc
    [rnm-75E.kicad_pcb]
2021-05-14 length tuning
    [rnm-75E.kicad_pcb]
2021-05-14 hro usb
    [rnm-75E.sch]
2021-05-14 crystal arrangement
    [rnm-75E.kicad_pcb]
2021-05-14 crystal gnd routing changes
    [rnm-75E.kicad_pcb]
2021-05-14 updated led 5v to 15mil rail
    [rnm-75E.kicad_pcb]
2021-05-14 ground mcu 53
    [rnm-75E.kicad_pcb]
2021-05-14 moved right side diodes
    [rnm-75E.kicad_pcb]
2021-05-14 update rs_sw power rail
    [rnm-75E.kicad_pcb]
2021-05-14 reroute differential pair
    [rnm-75E.kicad_pcb, rnm-75E.sch]
2021-05-14 update rotary encoder
    [rnm-75E.kicad_pcb]
2021-05-14 update encoder
    [rnm-75E.kicad_pcb]
2021-05-14 split ls/bs
    [rnm-75E-B_Cu.gbr, rnm-75E-B_Mask.gbr, rnm-75E-B_Paste.gbr, rnm-75E-B_SilkS.gbr, rnm-75E-Edge_Cuts.gbr, rnm-75E-F_Cu.gbr, rnm-75E-F_Mask.gbr, rnm-75E-F_Paste.gbr]
2021-05-15 update ground caps
    [rnm-75E.kicad_pcb]
2021-05-15 reroute main ground
    [rnm-75E.kicad_pcb]
2021-05-15 plate generation
2021-05-16 fancy plate and new oleds
    [OLED 32x 128.SLDPRT]
2021-05-16 no iso enter
    [ai03 plate.dxf, asm_mx_asm_PCB.stp, kbplate.dxf, rnm-75E.kicad_pcb, rnm-75E.sch]
2021-05-17 sent to manu
    [EC11_Rotary_Encoder_Switched.step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]
2021-05-18 with holes step
2021-05-18 plate3 gerbers
    [plate-B_Cu.gbr, plate-B_Mask.gbr, plate-B_Paste.gbr, plate-B_SilkS.gbr, plate-Edge_Cuts.gbr, plate-F_Cu.gbr, plate-F_Mask.gbr, plate-F_Paste.gbr]
2021-05-18 small holes
    [rnm-75E.kicad_pcb]
2021-05-18 new plate
2021-05-29 plate layout
    [midplate2.dxf, midplate3.dxf, midplate4.dxf, rnm-75E.sch]
